DimaLeshchinskiy/AnalogQuantumSimulator/electro/main/main.csv

Reference | Qty | Value | DNP | Exclude from BOM | Exclude from Board | Exclude from Simulation | Exclude from Position Files | Footprint | Datasheet
BT1,BT2 | 2 | Battery_Cell |  |  |  |  | ${EXCLUDE_FROM_POS_FILES}
C1,C3,C4,C5,C6,C7 | 6 | 100nF |  |  |  |  | ${EXCLUDE_FROM_POS_FILES} | Capacitor_THT:C_Disc_D7.0mm_W2.5mm_P5.00mm
C2,C8 | 2 | 10µF |  |  |  |  | ${EXCLUDE_FROM_POS_FILES} | Capacitor_THT:C_Radial_D5.0mm_H11.0mm_P2.00mm
D3,D4 | 2 | LED |  |  |  |  | ${EXCLUDE_FROM_POS_FILES} | LED_THT:LED_D5.0mm
J1 | 1 | Conn_02x03_Odd_Even |  |  |  |  | ${EXCLUDE_FROM_POS_FILES} | Connector_PinHeader_2.54mm:PinHeader_2x03_P2.54mm_Vertical
J2 | 1 | Conn_01x02_Socket_Laser |  |  |  |  | ${EXCLUDE_FROM_POS_FILES} | Connector_PinHeader_2.54mm:PinHeader_1x02_P2.54mm_Vertical
J3 | 1 | Conn_01x02_Socket_VOUT_3V |  |  |  |  | ${EXCLUDE_FROM_POS_FILES} | Connector_PinHeader_2.54mm:PinHeader_1x02_P2.54mm_Vertical
J6,J7 | 2 | Conn_01x03_Socket_BPW34_shield |  |  |  |  | ${EXCLUDE_FROM_POS_FILES} | Connector_PinHeader_2.54mm:PinHeader_1x03_P2.54mm_Vertical
R1,R2 | 2 | 330Ω |  |  |  |  | ${EXCLUDE_FROM_POS_FILES} | Resistor_THT:R_Axial_DIN0207_L6.3mm_D2.5mm_P10.16mm_Horizontal
R5,R6 | 2 | 10kΩ |  |  |  |  | ${EXCLUDE_FROM_POS_FILES} | Resistor_THT:R_Axial_DIN0207_L6.3mm_D2.5mm_P10.16mm_Horizontal
SW1 | 1 | SW_Push |  |  |  |  | ${EXCLUDE_FROM_POS_FILES} | Button_Switch_THT:SW_PUSH_6mm
SW2 | 1 | SW_SPST |  |  |  |  | ${EXCLUDE_FROM_POS_FILES}
TP1,TP2,TP3,TP4 | 4 | TestPoint |  |  |  |  | ${EXCLUDE_FROM_POS_FILES} | TestPoint:TestPoint_Bridge_Pitch2.54mm_Drill1.0mm
TPS1 | 1 |  |  |  |  |  | ${EXCLUDE_FROM_POS_FILES}
U1 | 1 | ATtiny13A-S |  |  |  |  | ${EXCLUDE_FROM_POS_FILES} | Package_SO:SOIC-8_5.3x5.3mm_P1.27mm | https://ww1.microchip.com/downloads/aemDocuments/documents/MCU08/ProductDocuments/DataSheets/ATtiny13A-Data-Sheet-DS40002307A.pdf
U2 | 1 | TS912 |  |  |  |  | ${EXCLUDE_FROM_POS_FILES} | Package_SO:SOIC-8_3.9x4.9mm_P1.27mm | www.st.com/resource/en/datasheet/ts912.pdf
