DimaLeshchinskiy/AnalogQuantumSimulator/construction/core/Nut_Holder_M3mm.STL

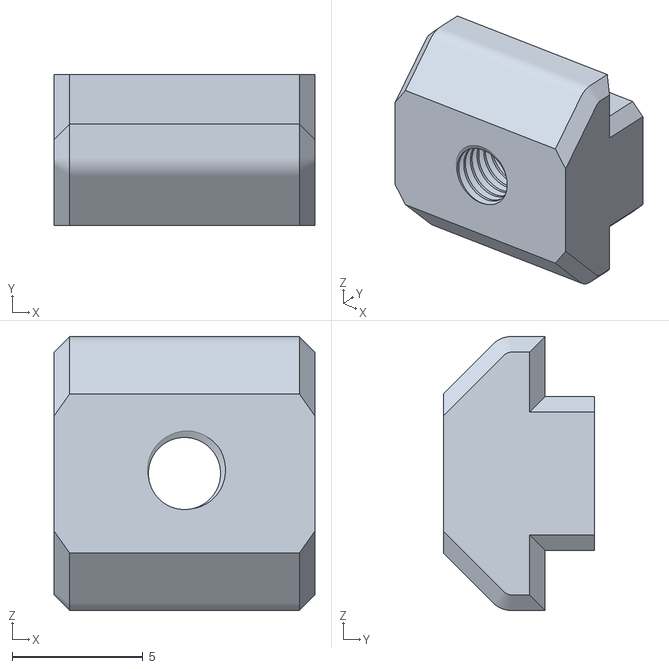
[picture p11: CAD file, 2026-11-11]
construction/core/Nut_Holder_M3mm.STL
10.0 x 5.80 x 10.5
