DimaLeshchinskiy/AnalogQuantumSimulator/construction/print/bpw34_holder.scad

use <../parts/bpw34_holder.scad>;
bpw34_holder();
