DimaLeshchinskiy/AnalogQuantumSimulator/construction/print/filter_cassette.scad

use <../parts/rotation_plate.scad>;
filter_cassette();
