DimaLeshchinskiy/AnalogQuantumSimulator/construction/print/laser_holder.scad

use <../parts/laser_holder.scad>;
laser_holder();
