DimaLeshchinskiy/AnalogQuantumSimulator/construction/print/pbs_holder.scad

use <../parts/pbs_holder.scad>;
pbs_holder();
