DimaLeshchinskiy/AnalogQuantumSimulator/construction/print/rotation_rotor.scad

use <../parts/rotation_plate.scad>;
rotation_rotor_disc();
