DimaLeshchinskiy/AnalogQuantumSimulator/construction/print/rotation_stator.scad

use <../parts/rotation_plate.scad>;
rotation_stator(y=0);
