DimaLeshchinskiy/AnalogQuantumSimulator/docs/04-experiments.md

# Trying the gates, one cassette at a time

[Project](../README.md) · [The mathematics](01-theory.md) · [What I learned](05-limitations-and-lessons.md)

I began with the simplest question the apparatus could answer: could I prepare a polarization and recognize it at the outputs? From there I added one plate, then two, and eventually the phase-oracle sequence I had wanted to build.

For all of these experiments I power the laser from a **3 V power supply**. Before inserting foils, I orient the polarized laser until the laser and PBS alone give roughly equal spots. That is the starting adjustment that has worked best for me. The LP then prepares H or V; I do not use the bare laser's 50/50 split as a substitute for that preparation.

The chains below run from laser to PBS, omitting empty holders. I reference angles to the H/V optical axes established with the LP, rather than assuming a printed zero is exact.

## Reading the calculations

Before putting in the first gate, I need a way to describe what goes into it. I write the polarization as a column vector:

```math
|\psi\rangle=\begin{pmatrix}\alpha\\\beta\end{pmatrix},
\qquad
|H\rangle=|0\rangle=\begin{pmatrix}1\\0\end{pmatrix},
\qquad
|V\rangle=|1\rangle=\begin{pmatrix}0\\1\end{pmatrix}.
```

The notation $|\psi\rangle$ is just a name for that vector. The top entry is the horizontal field amplitude and the bottom entry is the vertical amplitude. I normalize them so $|\alpha|^2+|\beta|^2=1$. The PBS reads out the squared magnitudes:

```math
P_H=|\alpha|^2,\qquad P_V=|\beta|^2.
```

Thus $(1,0)^T$ gives 100/0, while $(1,1)^T/\sqrt2$ gives 50/50 because $(1/\sqrt2)^2=1/2$. The entries themselves are amplitudes, not percentages. Negative entries do not mean negative brightness. For complex entries, $i^2=-1$ and $|a+ib|^2=a^2+b^2$ for real $a,b$; I will need this in the QWP experiment.

A gate acts by multiplying its matrix by the state column. Each output entry is a row of the matrix multiplied by the column:

```math
G|\psi\rangle=
\begin{pmatrix}a&b\\c&d\end{pmatrix}
\begin{pmatrix}\alpha\\\beta\end{pmatrix}
=
\begin{pmatrix}a\alpha+b\beta\\c\alpha+d\beta\end{pmatrix}.
```

If light passes through gate A and then gate B, I calculate $B(A|\psi\rangle)=BA|\psi\rangle$: the matrix closest to the state acts first. I can either follow the state after each plate or multiply the gate matrices first.

This is also how ideal single-qubit quantum gates act on qubit states. My beam uses the same algebra, with normalized classical intensities in place of single-photon outcome probabilities.

## The gate matrices I use

These are all the gate matrices needed for the experiments below:

```math
I=\begin{pmatrix}1&0\\0&1\end{pmatrix},
\qquad
X=\begin{pmatrix}0&1\\1&0\end{pmatrix},
```

```math
Z=\begin{pmatrix}1&0\\0&-1\end{pmatrix},
\qquad
H=\frac1{\sqrt2}\begin{pmatrix}1&1\\1&-1\end{pmatrix},
```

```math
Q=\begin{pmatrix}1&0\\0&i\end{pmatrix}.
```

$I$ is identity: it leaves the vector unchanged and needs no plate in the oracle position. $X$ swaps the two entries; I implement it with an HWP at 45°. $Z$ changes the sign of the V amplitude, using an HWP at 0°. $H$ mixes the two amplitudes, using an HWP at 22.5°. Plain $H$ means the **Hadamard matrix**, while $|H\rangle$ means the **horizontal state**.

For $Q$ I use a QWP at 0°, with the convention that it multiplies the V amplitude by $i$. All five matrices preserve normalization in the ideal model. The LP prepares the input before these gates by transmitting the selected linear polarization and discarding some light.

I judged the results by the spots on paper. The ideal fractions come from the matrices; my approximate real ratios are visual estimates. I did not use the unfinished photodiode readout or calculate intensities from camera pixels.

## Reading the spots in the photographs

For these visual comparisons I focus on the **compact dots at the two PBS output positions**. Several photographs also show a broad green halo around a dot. I treat that glow as an imperfection and set it aside when comparing the dots: the total illuminated area can give a misleading impression of which output is stronger.

This matters particularly in the LP(V), single-NOT and Deutsch–Jozsa photographs. A distinct compact dot in the unwanted output is still real leakage. Looking past the halo is a qualitative viewing choice, not a calibrated correction of total optical power. I have not established its cause, so I do not identify it as dispersion from these images alone.

## 1. Finding H and V

I first put only the LP in the beam:

`LP(H) → PBS`, then `LP(V) → PBS`.

Rotating it by 90° let me identify the two output channels. For ideal H input, $(1,0)^T$, all the output is H; for V, $(0,1)^T$, all is V. I therefore expected 100/0 and 0/100.

| LP set to H | LP set to V |
| --- | --- |
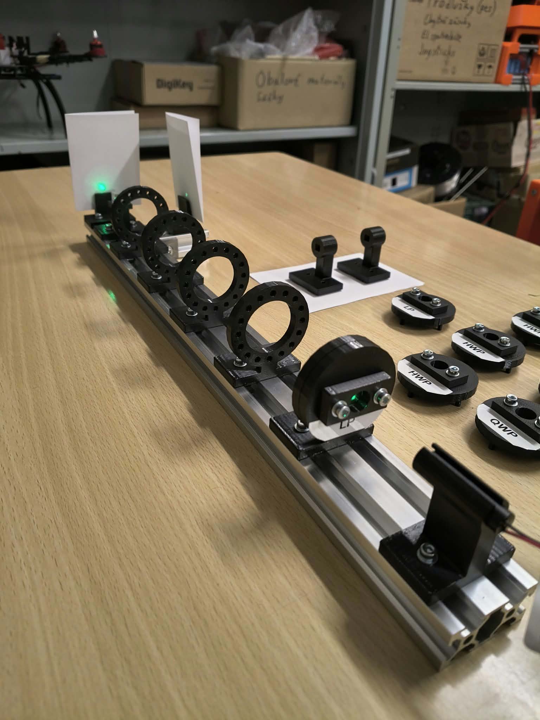
[picture p12: images/lp_h.jpg]
My H preparation with a linear polarizer and the PBS output spots
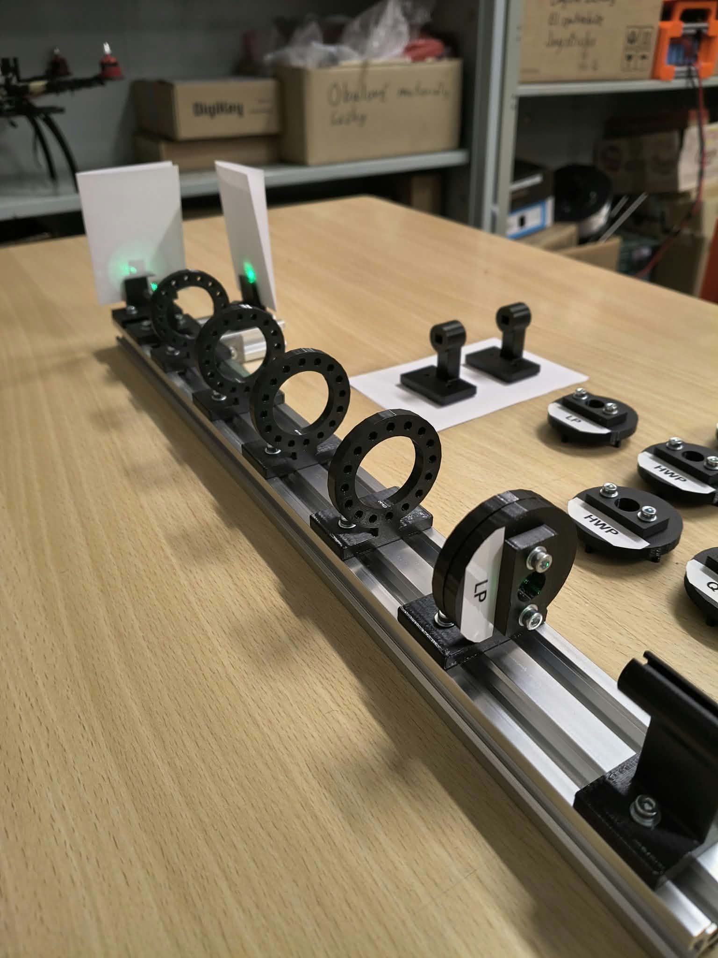
[picture p13: images/lp_v.jpg]
My V preparation after rotating the linear polarizer by 90 degrees
|  |  |

*The same setup with the LP rotated. In the V photograph, focus on the compact dots rather than the diffuse glow around them when judging which channel is brighter.*

The bright output changed as expected. It gave me a reference for the rest of the experiments, although weak light in the other direction could still come from imperfect extinction, alignment or scattering. I did not measure an extinction ratio.

## 2. Putting in a Hadamard

Next I kept H preparation and inserted an HWP at 22.5°:

`LP(H) → HWP(22.5°) → PBS`.

The calculation was short enough to keep beside the apparatus:

```math
\begin{aligned}
H|H\rangle
&=\frac1{\sqrt2}
\begin{pmatrix}1&1\\1&-1\end{pmatrix}
\begin{pmatrix}1\\0\end{pmatrix}\\
&=\frac1{\sqrt2}
\begin{pmatrix}1\cdot1+1\cdot0\\1\cdot1+(-1)\cdot0\end{pmatrix}\\
&=\frac1{\sqrt2}\begin{pmatrix}1\\1\end{pmatrix}
=\frac{|H\rangle+|V\rangle}{\sqrt2}=|+\rangle.
\end{aligned}
```

Both components have squared magnitude $1/2$, so I expected two equal spots. That is approximately what I saw.

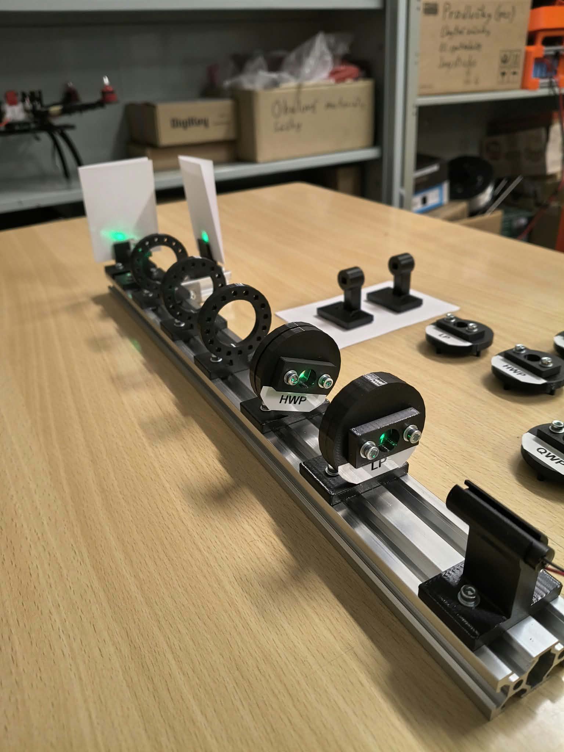
[picture p14: images/hadamard.jpg]
My Hadamard experiment with an LP and one HWP in the beam, producing two visible PBS spots


*H preparation followed by the nominal 22.5° HWP.*

This was the first direct connection between a gate matrix and a visible change. It was also only one input tested in one basis: a 50/50 output by itself cannot establish the relative phase or certify the whole Hadamard transformation.

## 3. Adding a second Hadamard

I then inserted another HWP at the same nominal angle:

`LP(H) → HWP₁(22.5°) → HWP₂(22.5°) → PBS`.

This time I can multiply the gate matrices before applying them to the input. Each entry of the product comes from a row of the left matrix and a column of the right one:

```math
\begin{aligned}
HH
&=\frac12
\begin{pmatrix}1&1\\1&-1\end{pmatrix}
\begin{pmatrix}1&1\\1&-1\end{pmatrix}\\
&=\frac12
\begin{pmatrix}
1\cdot1+1\cdot1 & 1\cdot1+1\cdot(-1)\\
1\cdot1+(-1)\cdot1 & 1\cdot1+(-1)\cdot(-1)
\end{pmatrix}\\
&=\frac12\begin{pmatrix}2&0\\0&2\end{pmatrix}
=\begin{pmatrix}1&0\\0&1\end{pmatrix}=I.
\end{aligned}
```

The two factors $1/\sqrt2$ give the $1/2$ in front. The off-diagonal entries cancel, and the diagonal entries become one. This is the identity matrix for **any input state**, not just H.

For the input I prepared here,

```math
HH|H\rangle=I\begin{pmatrix}1\\0\end{pmatrix}
=\begin{pmatrix}1\\0\end{pmatrix}=|H\rangle.
```

I therefore expect H again, or 100/0. The output returned close to the original polarization.

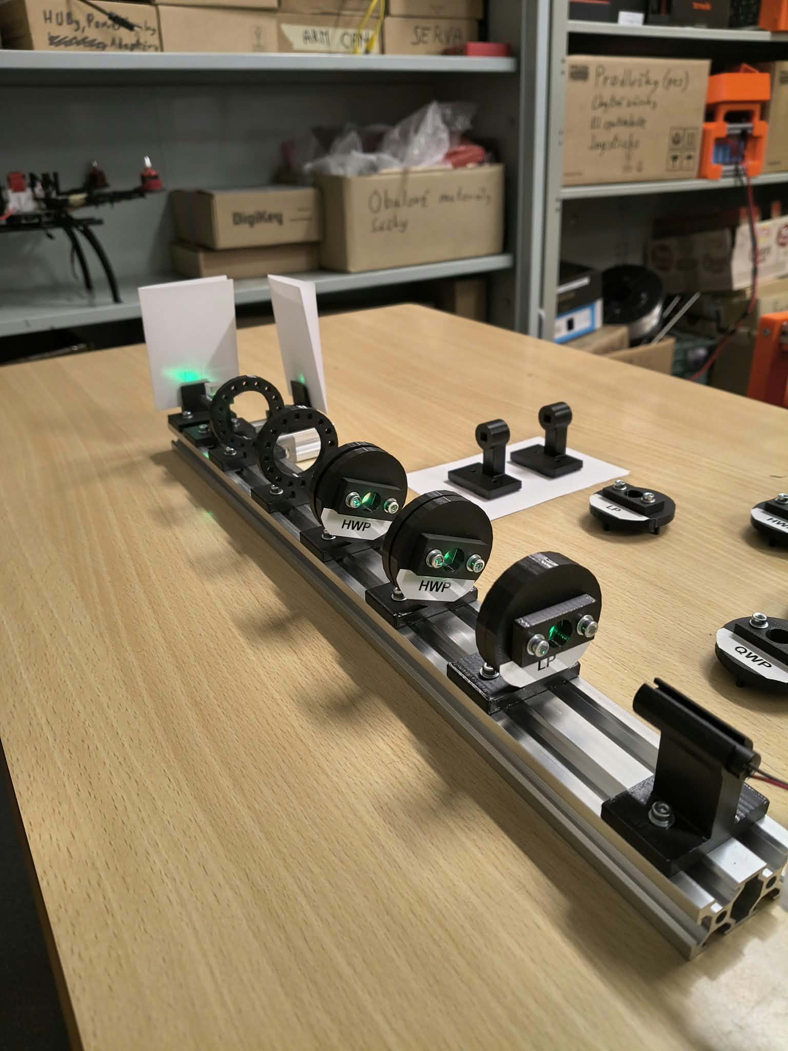
[picture p15: images/double_hadamard.jpg]
My two-Hadamard sequence with two HWP cassettes and a dominant PBS output spot


*Two physical plates implementing the nominal $H^2$ sequence.*

The important difference from the calculation is that these are two separate foils. They need not have identical retardance or identical offsets between their optical axes and cassette marks. Returning approximately to H was useful evidence for the sequence, but not proof that it acted as identity on every possible input.

## 4. Swapping the output, then trying to swap it back

For NOT, I changed the HWP setting to 45°:

`LP(H) → HWP(45°) → PBS`.

The X matrix swaps the two amplitudes. For my H input,

```math
X|H\rangle=
\begin{pmatrix}0&1\\1&0\end{pmatrix}
\begin{pmatrix}1\\0\end{pmatrix}
=\begin{pmatrix}0\\1\end{pmatrix}=|V\rangle.
```

It also works in the other direction:

```math
X|V\rangle=
\begin{pmatrix}0&1\\1&0\end{pmatrix}
\begin{pmatrix}0\\1\end{pmatrix}
=\begin{pmatrix}1\\0\end{pmatrix}=|H\rangle.
```

For the photographed H input, I expect $(P_H,P_V)=(|0|^2,|1|^2)=(0,1)$, or 0/100. I saw the bright output move to the other channel, with some residual light left behind.

I also tried two NOT plates:

`LP(H) → HWP₁(+45°) → HWP₂(+45° or −45°) → PBS`.

| One NOT | Double NOT |
| --- | --- |
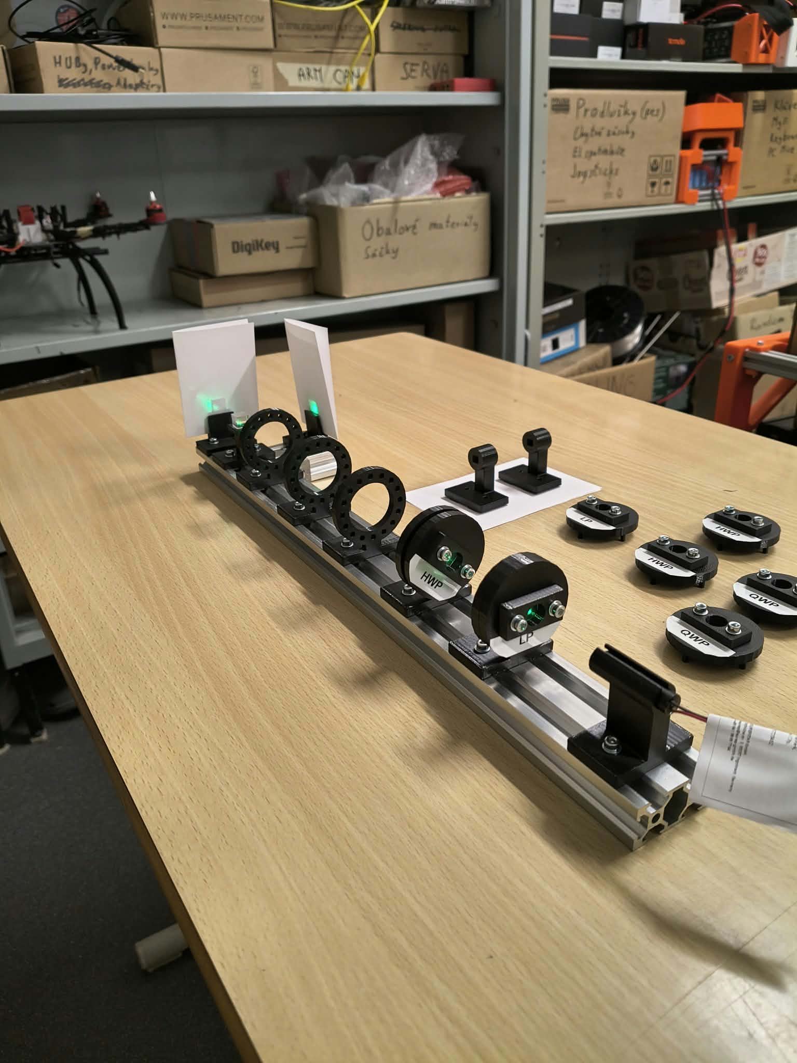
[picture p16: images/not.jpg]
My single-NOT optical sequence with one HWP after the LP
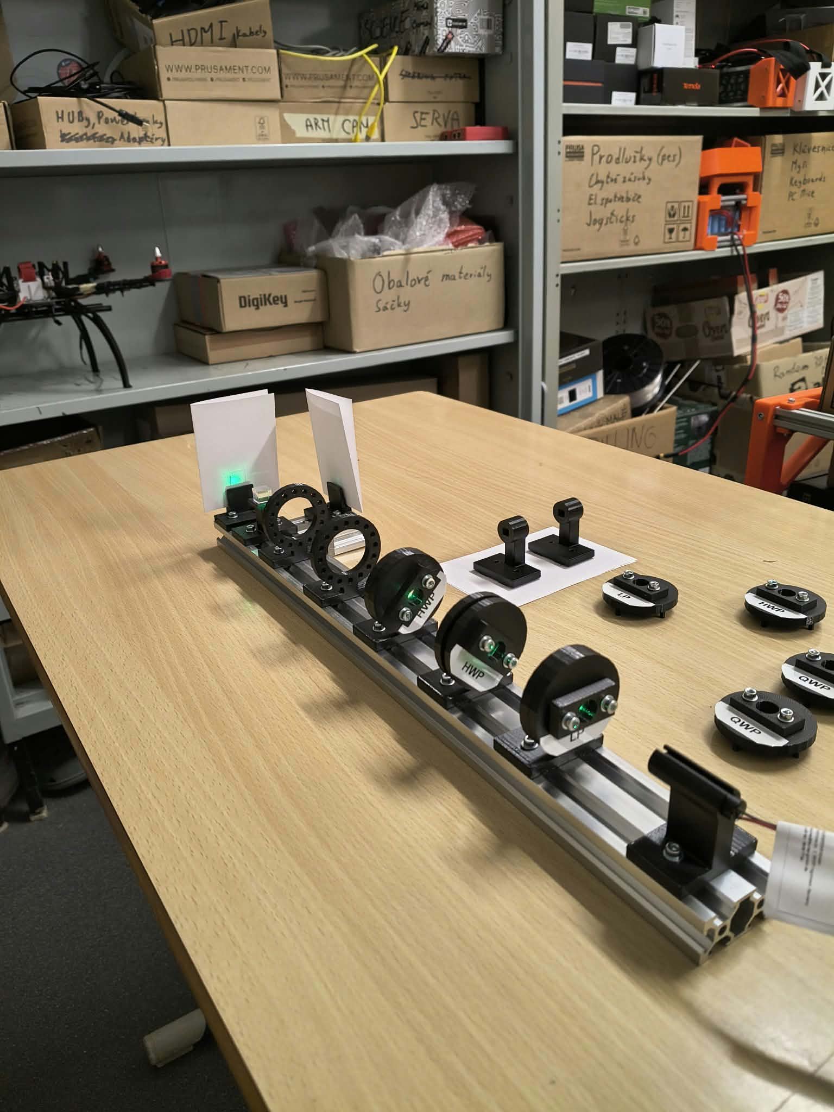
[picture p17: images/double_not.jpg]
My double-NOT sequence with two HWP cassettes after the LP
|  |  |

*The single- and double-plate tests. In the one-NOT photograph, compare the compact dots and set aside the broad surrounding glow. The cassette labels do not measure the true optical axes.*

For two ideal plates at +45°, the matrices multiply to

```math
XX=
\begin{pmatrix}0&1\\1&0\end{pmatrix}
\begin{pmatrix}0&1\\1&0\end{pmatrix}
=\begin{pmatrix}1&0\\0&1\end{pmatrix}=I.
```

Applying them to H therefore gives $XX|H\rangle=I|H\rangle=|H\rangle$: an ideal 100/0 return.

The −45° HWP has a slightly different matrix, $W_{1/2}(-45^\circ)=-X$. When it follows the +45° plate,

```math
(-X)X=
\begin{pmatrix}0&-1\\-1&0\end{pmatrix}
\begin{pmatrix}0&1\\1&0\end{pmatrix}
=\begin{pmatrix}-1&0\\0&-1\end{pmatrix}=-I.
```

On H input this produces $(-1,0)^T$. Its intensities are still $(|-1|^2,|0|^2)=(1,0)$. Multiplying the entire state by −1 changes only its global phase, so both ideal pairs return the same polarization and intensity pattern.

In practice the crossed +45°/−45° combination looked better than some same-orientation combinations. This was one point where the real apparatus became more interesting than simply matching the expected bright spot. Two equal-retardance plates with orthogonal axes can cancel a shared retardance error, which is a possible explanation. I did not characterize the foils well enough to prove it. Across different states and sequences I saw results ranging from nearly one bright channel to appearances around 60/40.

## 5. Reaching the Deutsch–Jozsa experiment

This was the sequence I had wanted to reach from the start. Before putting in the oracle plate, I needed to be clear about the problem it represents.

Imagine a black box containing a function $f$ that accepts one bit and returns one bit:

```math
f:\{0,1\}\longrightarrow\{0,1\}.
```

I can ask for $f(0)$ or $f(1)$; each request is one **query**. The question is whether the two answers are the same (**constant**) or different (**balanced**). I only need that classification, not both answers separately. This one-input case is usually called **Deutsch's problem**; it is the smallest case of Deutsch–Jozsa.

A classical algorithm that must always be correct needs both values. After learning, for example, $f(0)=0$, I still cannot tell whether $f(1)$ is 0 or 1. The ideal quantum algorithm applies its oracle once to a superposition and determines the class after the final Hadamard. This is the **one-query versus two-query** comparison explained in [IBM Quantum's lesson on Deutsch's algorithm](https://quantum.cloud.ibm.com/learning/en/courses/fundamentals-of-quantum-algorithms/quantum-query-algorithms/deutsch-algorithm).

The comparison counts oracle uses, not elapsed time or every operation in a computer. My optical setup illustrates the algebra with a classical beam; it is not a demonstration that my apparatus runs faster than a classical PC.

### Writing the black box as a phase matrix

I use a phase oracle: the function value controls the sign of each basis amplitude,

```math
U_f=
\begin{pmatrix}
(-1)^{f(0)}&0\\
0&(-1)^{f(1)}
\end{pmatrix}.
```

Because $(-1)^0=1$ and $(-1)^1=-1$, the four possibilities are easy to list:

| f(0) | f(1) | Class | Phase oracle |
| --- | --- | --- | --- |
| 0 | 0 | Constant | I |
| 1 | 1 | Constant | −I |
| 0 | 1 | Balanced | Z |
| 1 | 0 | Balanced | −Z |

The global minus signs do not change the output intensities. I therefore only need an empty oracle position for I and an HWP at 0° for Z. My optical chain is

`LP(H) → HWP(22.5°) → Oracle → HWP(22.5°) → PBS`.

### Following the state through the three steps

First, H takes my prepared input to

```math
|\psi_1\rangle=H|H\rangle
=\frac1{\sqrt2}\begin{pmatrix}1\\1\end{pmatrix}.
```

For shorter arithmetic, I call the two oracle signs $s_0=(-1)^{f(0)}$ and $s_1=(-1)^{f(1)}$. Each is either +1 or −1. The oracle gives

```math
|\psi_2\rangle=
\begin{pmatrix}s_0&0\\0&s_1\end{pmatrix}
\frac1{\sqrt2}\begin{pmatrix}1\\1\end{pmatrix}
=\frac1{\sqrt2}\begin{pmatrix}s_0\\s_1\end{pmatrix}.
```

At this point the squared magnitudes are still 50/50 in every case. The information is in the signs. The final H makes those signs affect the output:

```math
|\psi_{\mathrm{out}}\rangle
=\frac12
\begin{pmatrix}1&1\\1&-1\end{pmatrix}
\begin{pmatrix}s_0\\s_1\end{pmatrix}
=\frac12\begin{pmatrix}s_0+s_1\\s_0-s_1\end{pmatrix}.
```

For the identity oracle, both signs are +1:

```math
HIH|H\rangle
=\frac12\begin{pmatrix}1+1\\1-1\end{pmatrix}
=\begin{pmatrix}1\\0\end{pmatrix}=|H\rangle.
```

For the Z oracle, the signs are +1 and −1:

```math
HZH|H\rangle
=\frac12\begin{pmatrix}1+(-1)\\1-(-1)\end{pmatrix}
=\begin{pmatrix}0\\1\end{pmatrix}=|V\rangle.
```

Equal signs cancel in the bottom entry; opposite signs cancel in the top one. This is interference written as addition and subtraction. I obtain the classification without reading out the two function values individually.

At the gate level the constant sequence is $HIH=H^2=I$. For the balanced sequence I can also multiply the matrices directly:

```math
\begin{aligned}
HZH
&=\frac12
\begin{pmatrix}1&1\\1&-1\end{pmatrix}
\begin{pmatrix}1&0\\0&-1\end{pmatrix}
\begin{pmatrix}1&1\\1&-1\end{pmatrix}\\
&=\frac12
\begin{pmatrix}1&1\\1&-1\end{pmatrix}
\begin{pmatrix}1&1\\-1&1\end{pmatrix}\\
&=\frac12\begin{pmatrix}0&2\\2&0\end{pmatrix}
=\begin{pmatrix}0&1\\1&0\end{pmatrix}=X.
\end{aligned}
```

The ideal PBS result is therefore 100/0 for a constant function and 0/100 for a balanced one.

| Constant: identity oracle | Balanced: Z oracle |
| --- | --- |
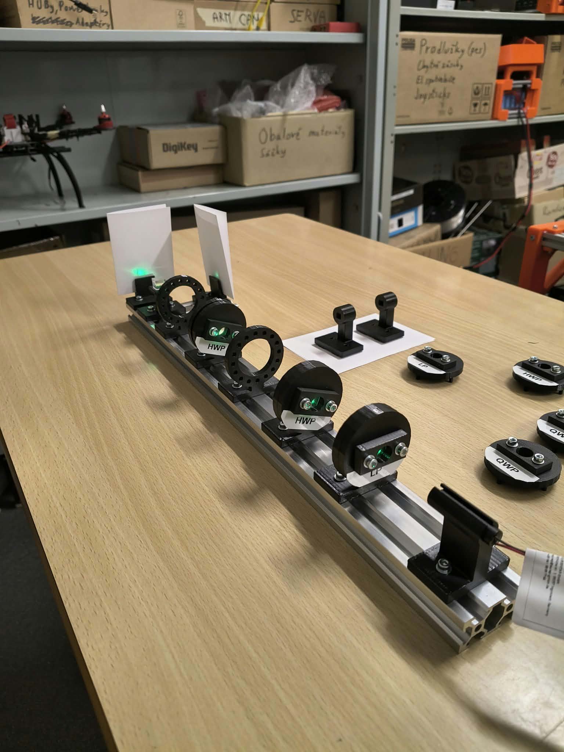
[picture p18: images/dj_constant_i.jpg]
My constant-oracle experiment with an empty oracle position between the two Hadamard plates
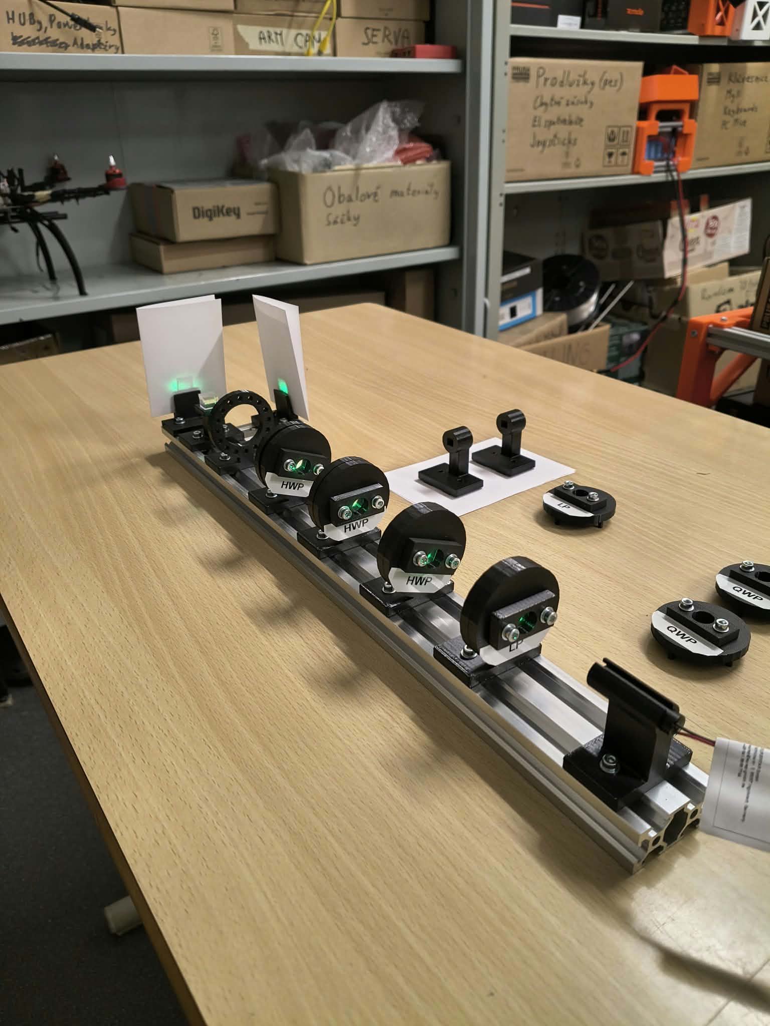
[picture p19: images/dj_balanced_z.jpg]
My balanced-oracle experiment with an additional HWP implementing Z between the Hadamard plates
|  |  |

*The two oracle configurations. I compare the compact output dots here; the surrounding green glow can make the illuminated area look misleadingly large.*

I saw the expected qualitative output swap, although the unwanted channel was not completely dark. I treat the broad halo as an imperfection and focus on the dots for this visual comparison. A distinct weak dot in the other output still counts as leakage. By then I was composing three real HWPs, so axis offsets, retardance errors and alignment could all affect the contrast; I did not establish the cause of the halo.

In the usual two-register quantum version, the oracle flips a target bit when $f(x)=1$. Preparing that target as $|-\rangle=(|0\rangle-|1\rangle)/\sqrt2$ makes a flip multiply it by −1, so the input acquires the factor $(-1)^{f(x)}$. That is the phase action I model here, without building an additional target register. Selecting known optical I and Z configurations demonstrates this principle, rather than benchmarking an unknown quantum oracle.

## 6. Looking for the phase that H/V could not show

For the last comparison I used a QWP. I wanted two states that looked alike in H/V, then an analyzer that would tell them apart.

I photographed two chains before the final analyzer:

- A: `LP(H) → HWP(22.5°) → PBS`.
- B: `LP(H) → HWP(22.5°) → QWP(0°) → PBS`.

A prepares $|+\rangle=(1,1)^T/\sqrt2$. With my QWP convention, the extra matrix in B gives

```math
Q|+\rangle=
\begin{pmatrix}1&0\\0&i\end{pmatrix}
\frac1{\sqrt2}\begin{pmatrix}1\\1\end{pmatrix}
=\frac1{\sqrt2}\begin{pmatrix}1\\i\end{pmatrix}
=|\psi_i\rangle.
```

The V amplitude now has a relative phase of a quarter-cycle. Its squared magnitude remains $|i/\sqrt2|^2=1/2$.

Both give ideal 50/50 H/V outputs. The PBS alone cannot reveal their relative-phase difference.

| A: without QWP | B: with QWP |
| --- | --- |
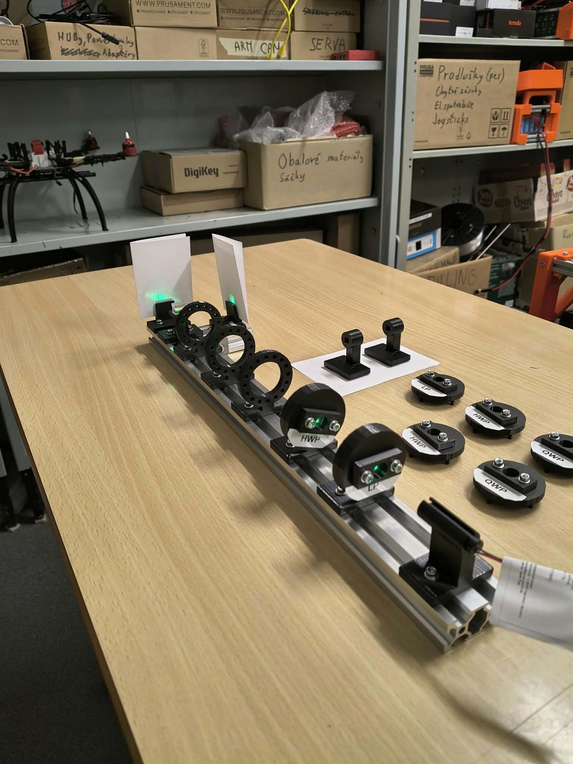
[picture p20: images/6_exp_a_before.jpg]
My QWP comparison A before the final analyzer, with LP and HWP
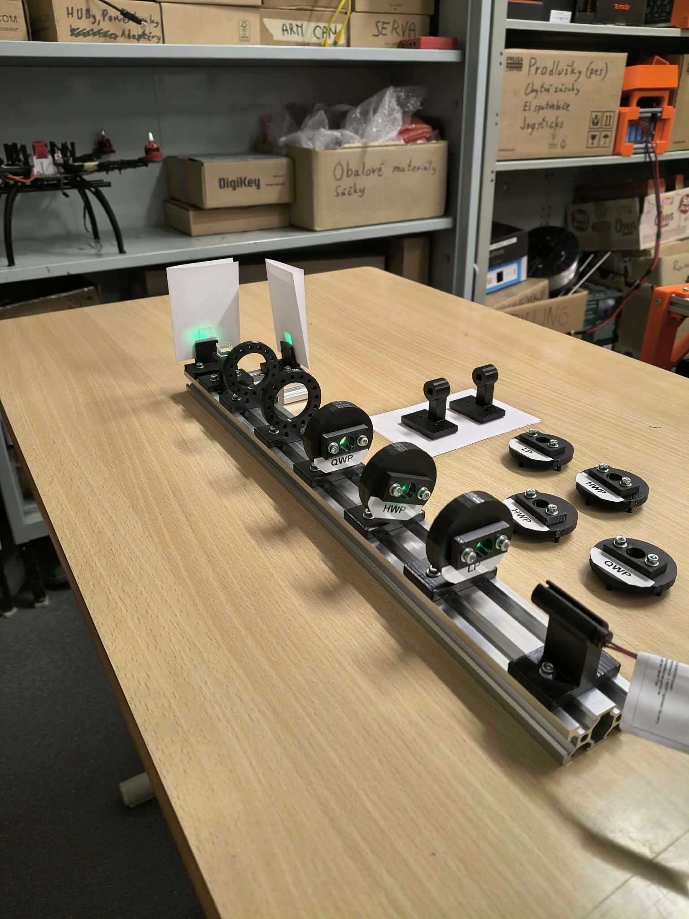
[picture p21: images/6_exp_b_before.jpg]
My QWP comparison B before the final analyzer, with LP, HWP and QWP
|  |  |

*Before the final analyzer: the ideal H/V intensities are the same for both states.*

I then put an HWP at 22.5° immediately before the PBS in each chain. In B the full sequence is LP, HWP, QWP, HWP, using four cassette positions.

The extra Hadamard changes the analysis basis. In A, the two equal amplitudes add in the top entry and cancel in the bottom one:

```math
H\frac1{\sqrt2}\begin{pmatrix}1\\1\end{pmatrix}
=\frac12\begin{pmatrix}1+1\\1-1\end{pmatrix}
=\begin{pmatrix}1\\0\end{pmatrix}=|H\rangle.
```

In B, the phase changes those sums:

```math
H\frac1{\sqrt2}\begin{pmatrix}1\\i\end{pmatrix}
=\frac12\begin{pmatrix}1+i\\1-i\end{pmatrix}.
```

Here $|(1+i)/2|^2=(1^2+1^2)/4=1/2$, and the bottom entry has the same squared magnitude. I therefore expect A to become 100/0 while B remains 50/50.

| A after the analyzer | B after the analyzer |
| --- | --- |
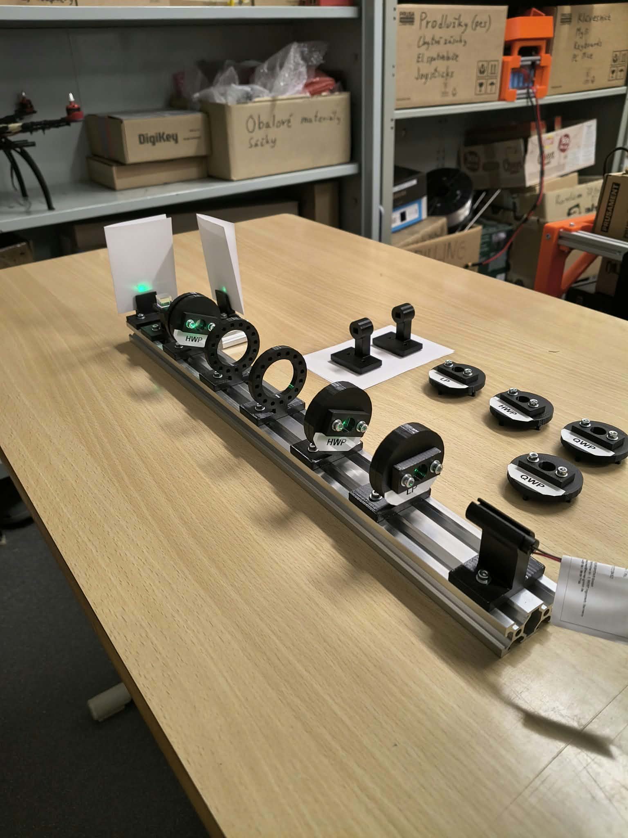
[picture p22: images/6_exp_a_after.jpg]
My comparison A with the final HWP analyzer added and one output visibly dominant
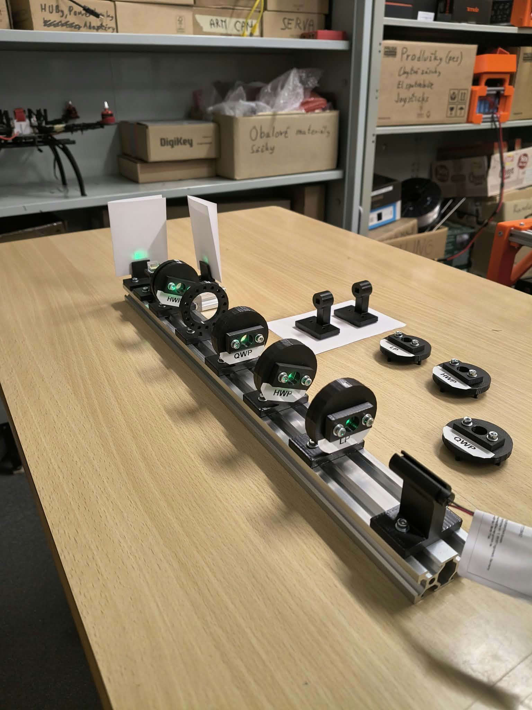
[picture p23: images/6_exp_b_after.jpg]
My comparison B with QWP and final HWP analyzer inserted
|  |  |

*The completed comparison. By eye I estimated roughly 80/20 without QWP and 40/60 with QWP after the analyzer; the ideal model predicts 100/0 and 50/50.*

This gave me the distinction I was looking for: one case became clearly dominated by one output, while the other stayed much closer to an even split. The results were imperfect, and I did not measure those ratios with detectors. I also would not claim that two equal H/V spots alone prove circular polarization or that this comparison amounts to full state tomography.

It was a useful place to finish. The phase was invisible in one measurement basis and affected the output in another, with the same plates and paper targets I had started with.

---

**Next chapter:** [What the imperfect results taught me](05-limitations-and-lessons.md) →
