DimaLeshchinskiy/AnalogQuantumSimulator/images/schema.pdf

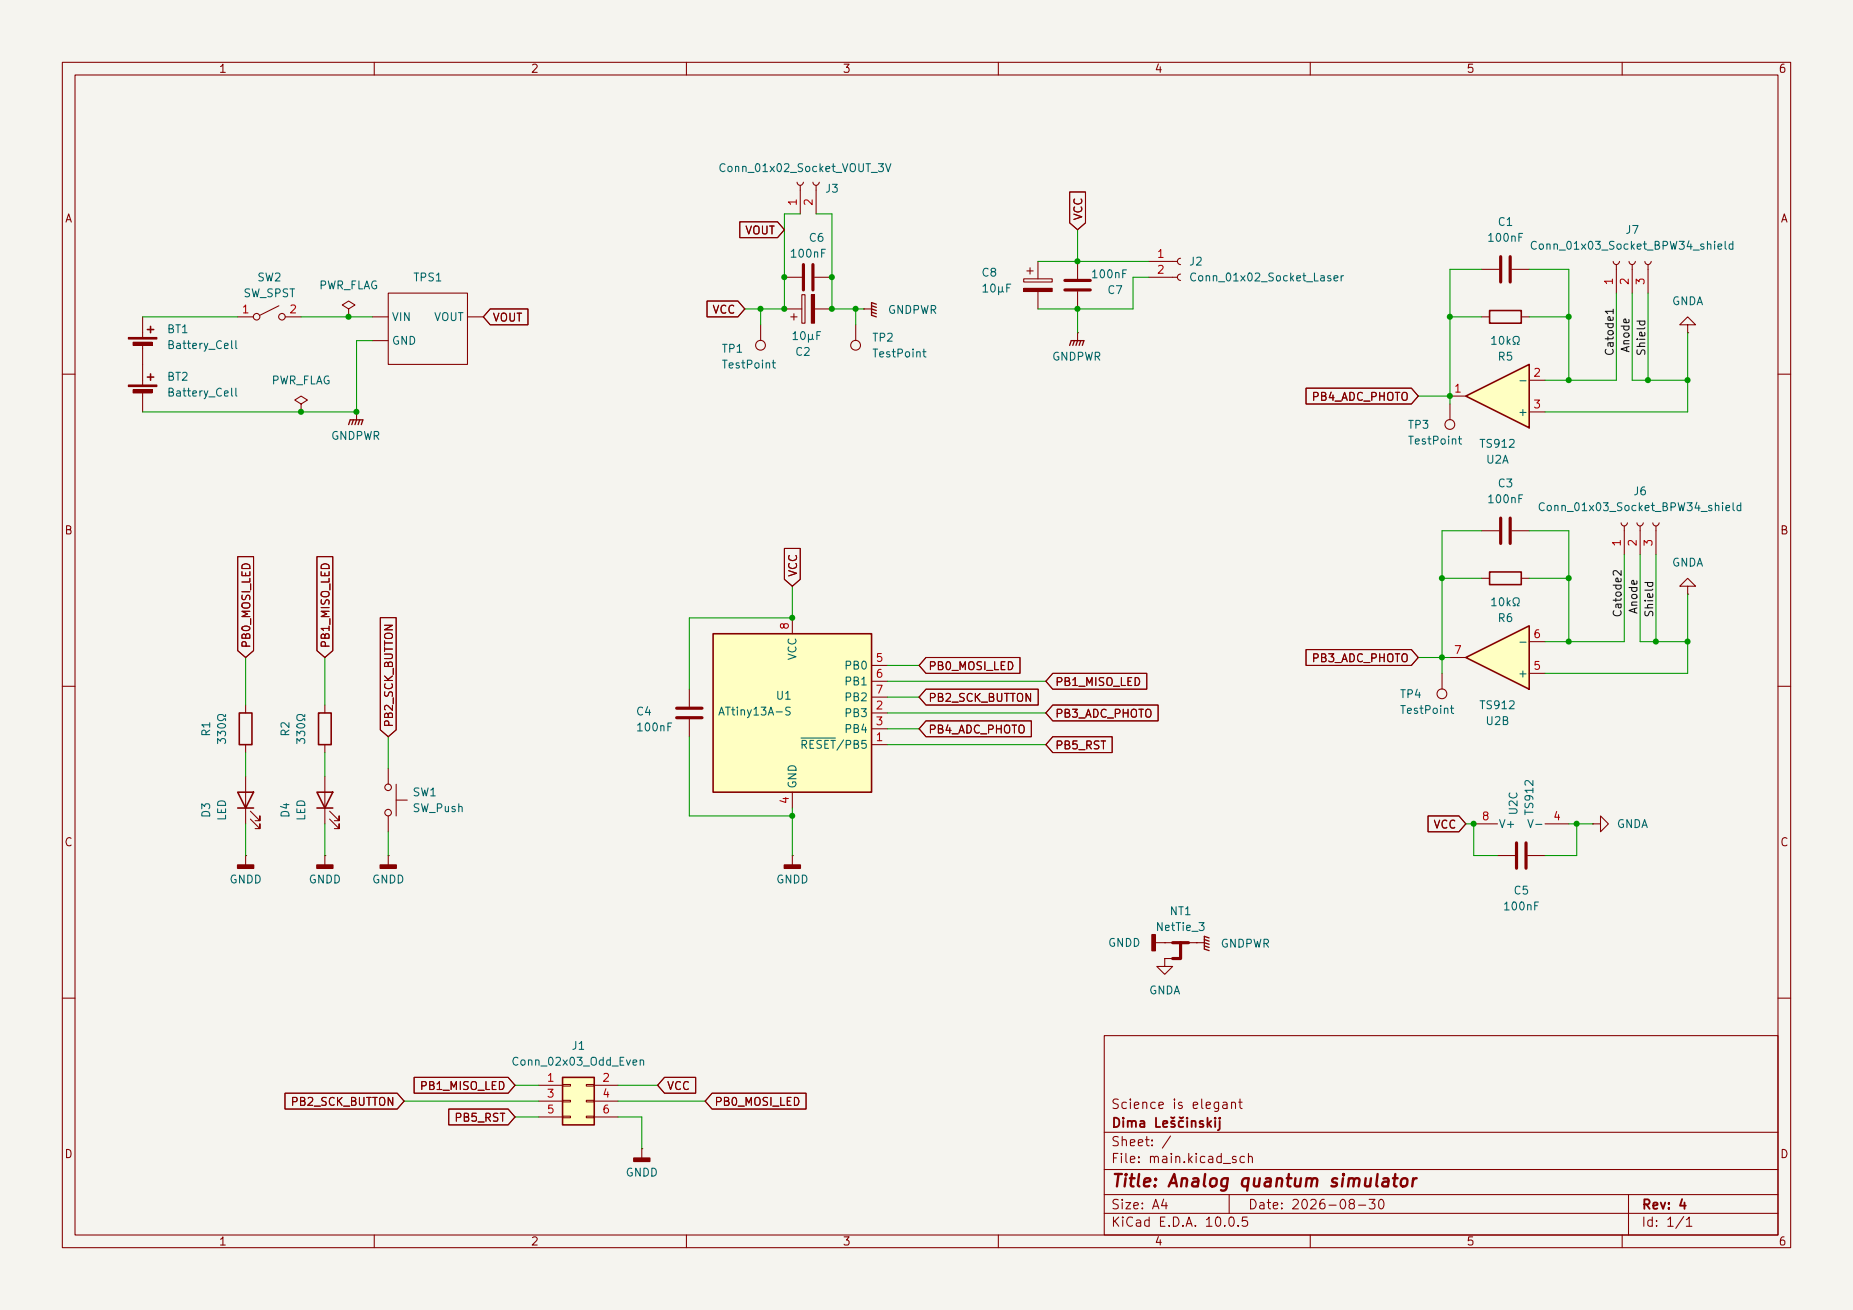
[picture p24: page 1]
