DimaLeshchinskiy/AnalogQuantumSimulator/(commit log)

2026-11-11 chore: preserve original mechanical and electronics design artifacts
    Record the supplied OpenSCAD models, KiCad project, local design snapshots, BOM and fabrication files before documenting the completed optical demonstrator. Preserve existing hardware files without design changes.
    [Nut_Holder_M3mm.STL, bpw34_holder.scad, fasteners.scad, filter_cassette.scad, full.scad, laser.scad, laser_holder.scad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]
2026-11-11 docs: document electronics history and qualify missing firmware
    Record the recovered KiCad design milestones, confirmed circuit connectivity, owner-reported programming and LED debugging, and unfinished detector integration. Document the exhaustive firmware search and preserve the supplied sketch unchanged under firmware/reference as an illustrative, unverified reconstruction.
    [attiny13a_reference_reconstruction.ino]
2026-11-11 docs: publish optical theory and six demonstration procedures
    Add the project landing page, consistent Jones-matrix derivations, optical component guide, six reproducible experiments and photo checklist. Separate ideal predictions from qualitative owner observations, keep the QWP experiment planned, and explain classical-optics limits and the four-versus-five holder discrepancy.
2026-11-11 docs: preserve experiment photographs and describe each configuration
    Add the thirteen supplied photographs unchanged and replace the empty shot list with an image catalog. Record the visible five-holder assembly, seven labeled cassettes and photographed QWP comparison.
2026-11-11 docs: tell the optical simulator story in the first person
    Replace repetitive audit-style chapters with a continuous personal account and embed all thirteen supplied photographs. Document the 3 V laser supply, polarized-source alignment near 50/50 before LP preparation, and the completed QWP comparison with visual 80/20 and 40/60 estimates. Preserve circuit history and pin details in a technical appendix, and retain the missing-firmware distinction.
2026-11-11 docs: retire the completed authoring briefs
    Record the existing removal of the two task briefs after incorporating their content into the public documentation. The original instructions remain available in Git history, and the current evidence notes no longer link to removed files.
2026-11-11 docs: add the PCB render and an inline schematic preview
    Preserve the supplied board render and schematic PDF unchanged, and render the PDF as a PNG for Markdown. Describe the illustrations in the image catalog and ignore local KiCad editor lock files.
2026-11-11 docs: focus the build chapter on electronics decisions and assembly
    Replace repository-search and save-history discussion with the detector design, PCB layout, Nano ISP programming, LED debugging and the decision to leave detector integration unfinished. Embed the real schematic and PCB render, retain a brief unverified-firmware note, and update its navigation anchor.
2026-11-11 docs: explain wave-plate rotation with input-state examples
    Explain optical axes and retardance, derive the HWP output-angle rule, and show how rotated QWPs affect horizontal, diagonal and circular inputs. Add verified ideal-state tables, a calculated polarization diagram and the existing laser/PBS holder previews. Keep ideal predictions separate from the apparatus calibration.
2026-11-11 docs: illustrate the mechanical build with existing CAD previews
    Publish the remaining assembly, cassette-mechanism and BPW34 holder renders unchanged, and place them beside the relevant build narrative. Extend the illustration catalog to cover all seven original CAD previews and the calculated wave-plate diagram.
